claritaadelia/Incubator-Platelet-Agitator/Hasil Hardware.jpg

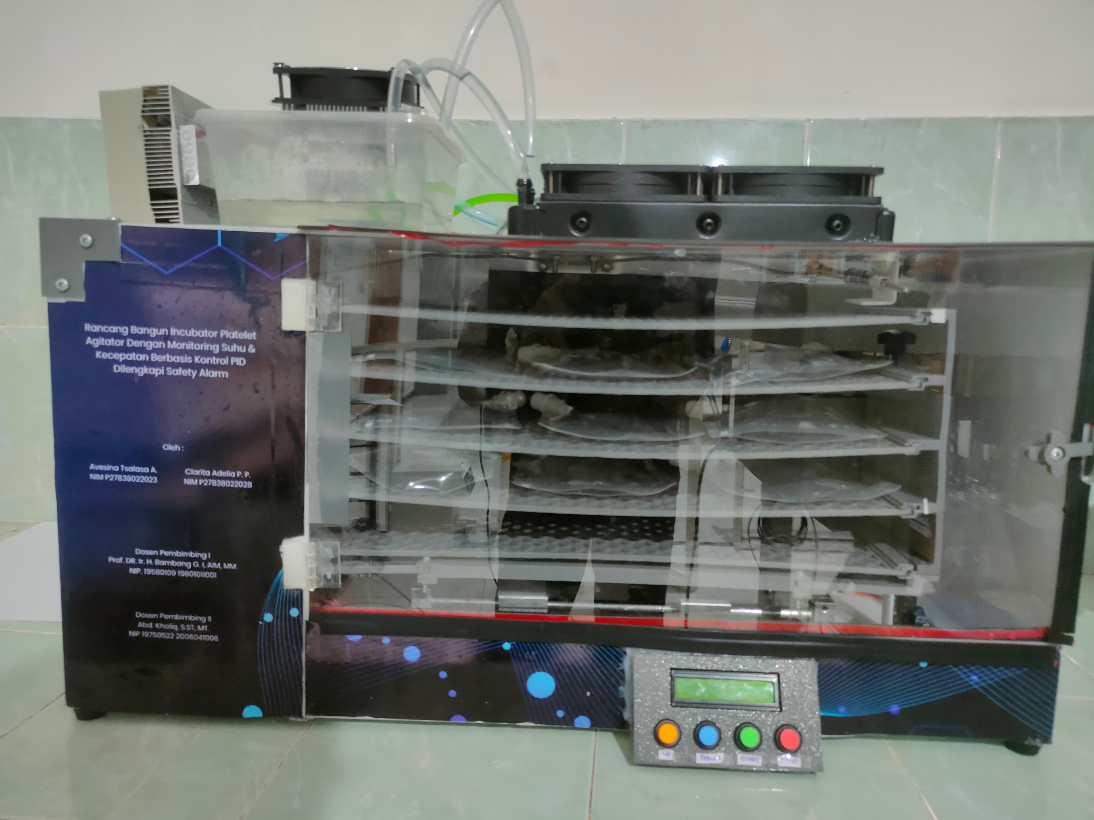
Hasil Hardware.jpg
