claritaadelia/Incubator-Platelet-Agitator/Blok diagram.jpg

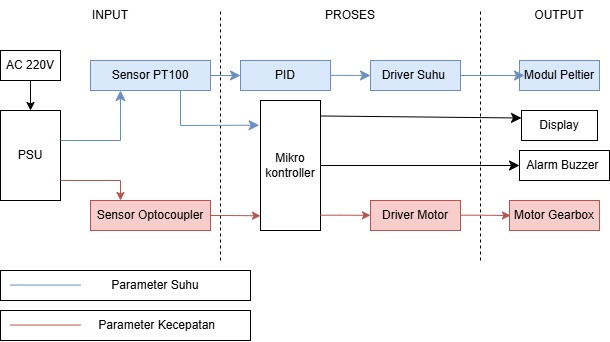
Blok diagram.jpg
