claritaadelia/Incubator-Platelet-Agitator/Diagram alir kecepatan.png

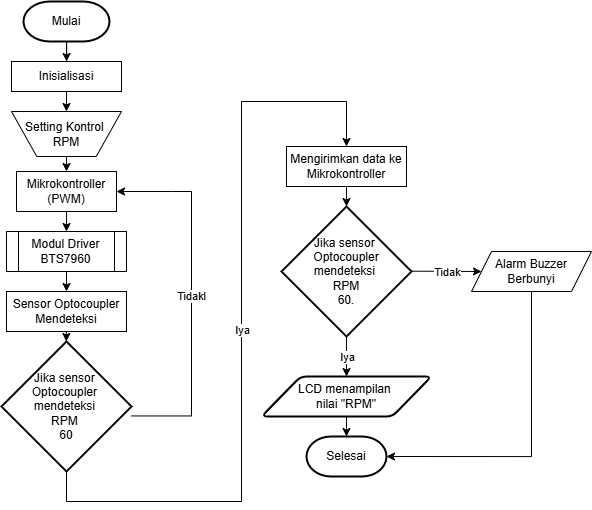
Diagram alir kecepatan.png
