claritaadelia/Incubator-Platelet-Agitator/Diagram Alir Suhu.drawio.png

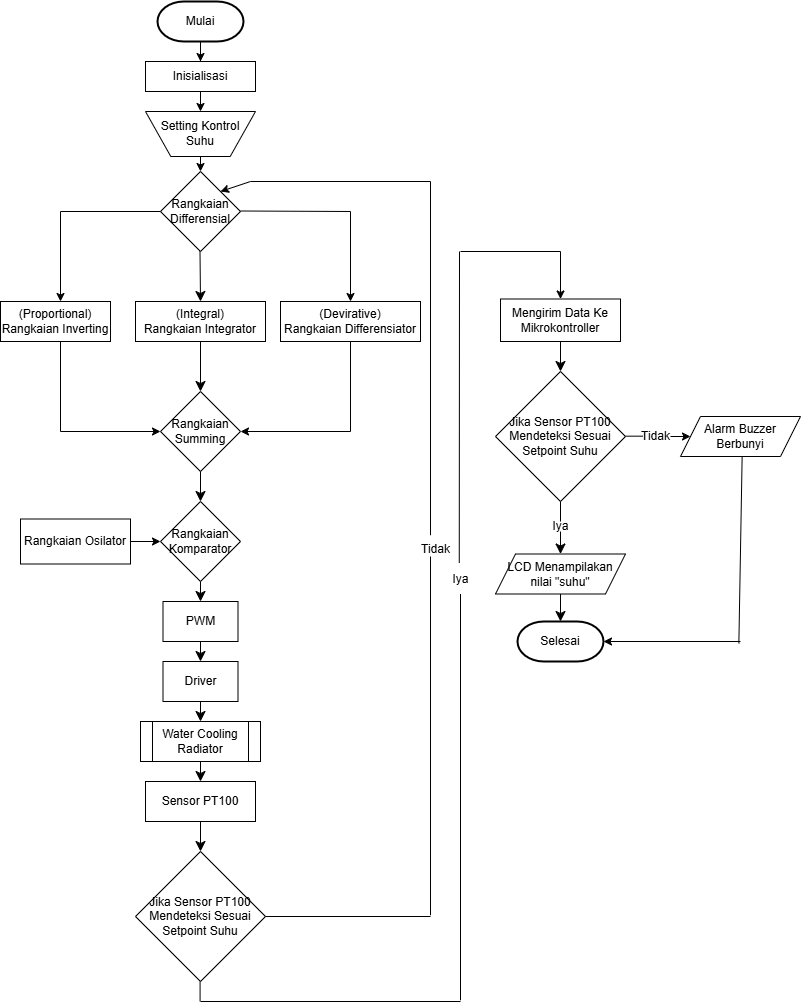
Diagram Alir Suhu.drawio.png
