claritaadelia/Incubator-Platelet-Agitator/Diagram Mekanis.png

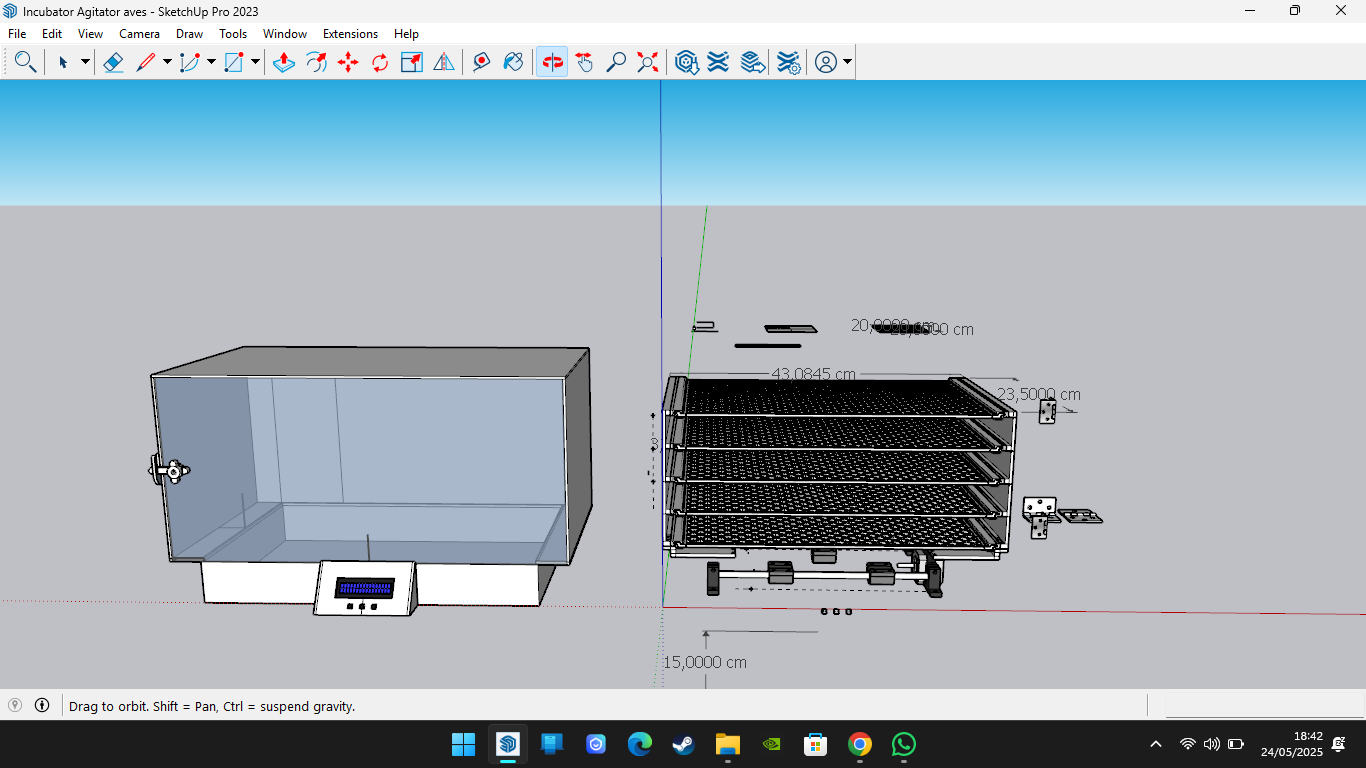
Diagram Mekanis.png
