claritaadelia/Incubator-Platelet-Agitator/MCP4725.brd

## EAGLE design MCP4725.brd (2025-05-24)

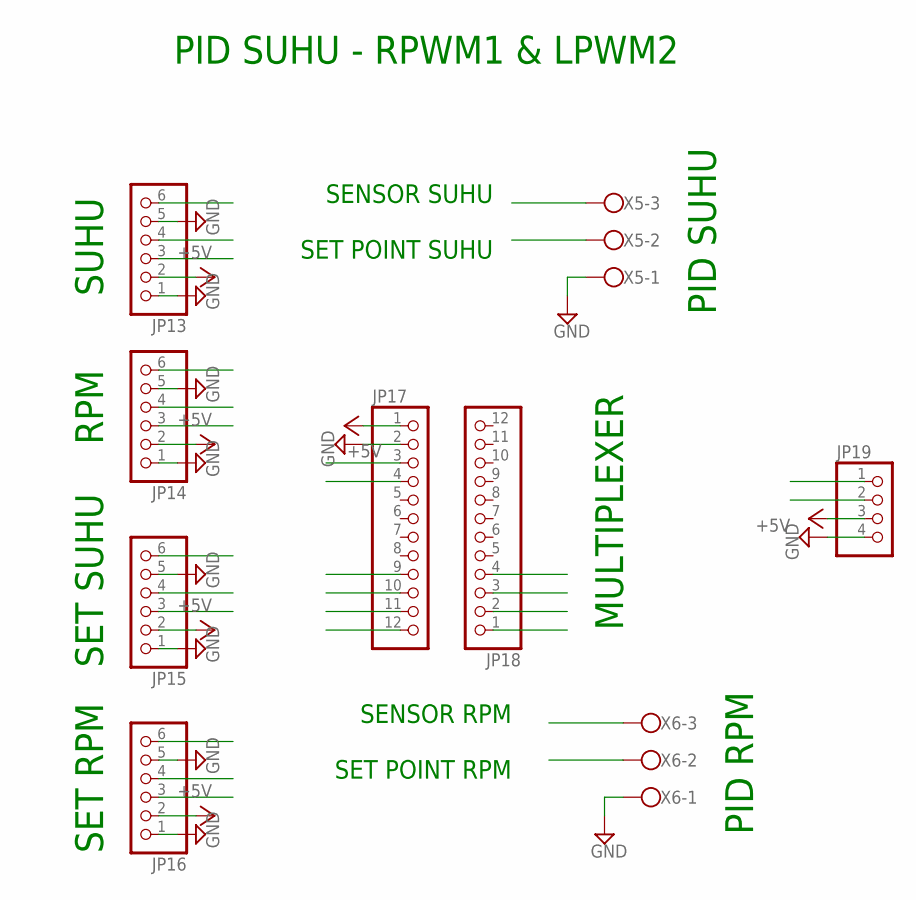
[picture p6: schematic MCP4725.sch]

Parts:
JP13, JP14, JP15, JP16: PINHD-1X6; 1X06
JP17, JP18: PINHD-1X12; 1X12
JP19: PINHD-1X4; 1X04
X5, X6: W237-103

Connections:
+5V: JP13.2, JP14.2, JP15.2, JP16.2, JP17.1, JP19.3
GND: JP13.1, JP13.5, JP14.1, JP14.5, JP15.1, JP15.5, JP16.1, JP16.5, JP17.2, JP19.4, X5.1, X6.1
unnamed: JP13.3, JP17.9
unnamed: JP13.4, JP17.10
unnamed: JP14.3, JP17.11
unnamed: JP14.4, JP17.12
unnamed: JP15.3, JP18.1
unnamed: JP15.4, JP18.2
unnamed: JP16.4, JP18.4
unnamed: JP16.3, JP18.3
unnamed: JP17.3, JP19.2
unnamed: JP17.4, JP19.1
unnamed: JP15.6, X5.2
unnamed: JP13.6, X5.3
unnamed: JP14.6, X6.3
unnamed: JP16.6, X6.2

Notes on the sheet:
SUHU
PID RPM
SET SUHU
RPM
SET RPM
PID SUHU
MULTIPLEXER
SENSOR SUHU
SET POINT SUHU
SENSOR RPM
SET POINT RPM
PID SUHU - RPWM1 & LPWM2

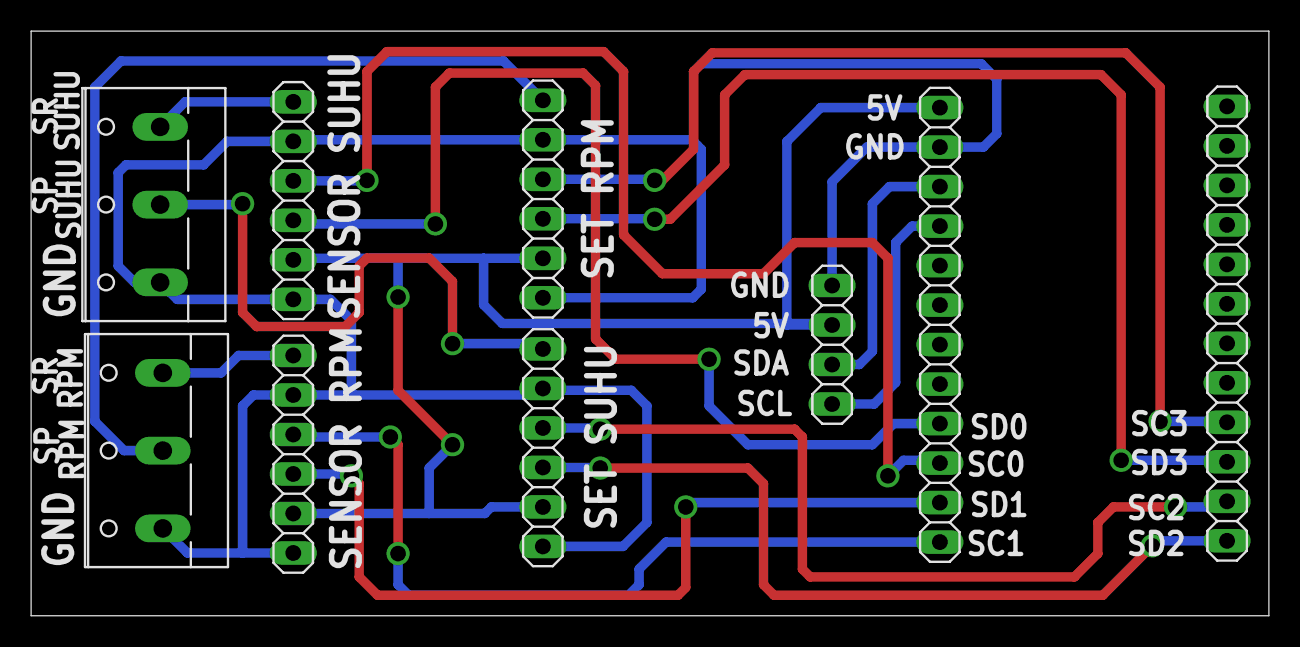
[picture p7: board MCP4725.brd from above]

Board: 2 copper layers, 79.6 x 37.6 mm, 9 parts (0 on the bottom side), 16 nets.
