claritaadelia/Incubator-Platelet-Agitator/agitator.brd

## EAGLE design agitator.brd (2025-05-24)

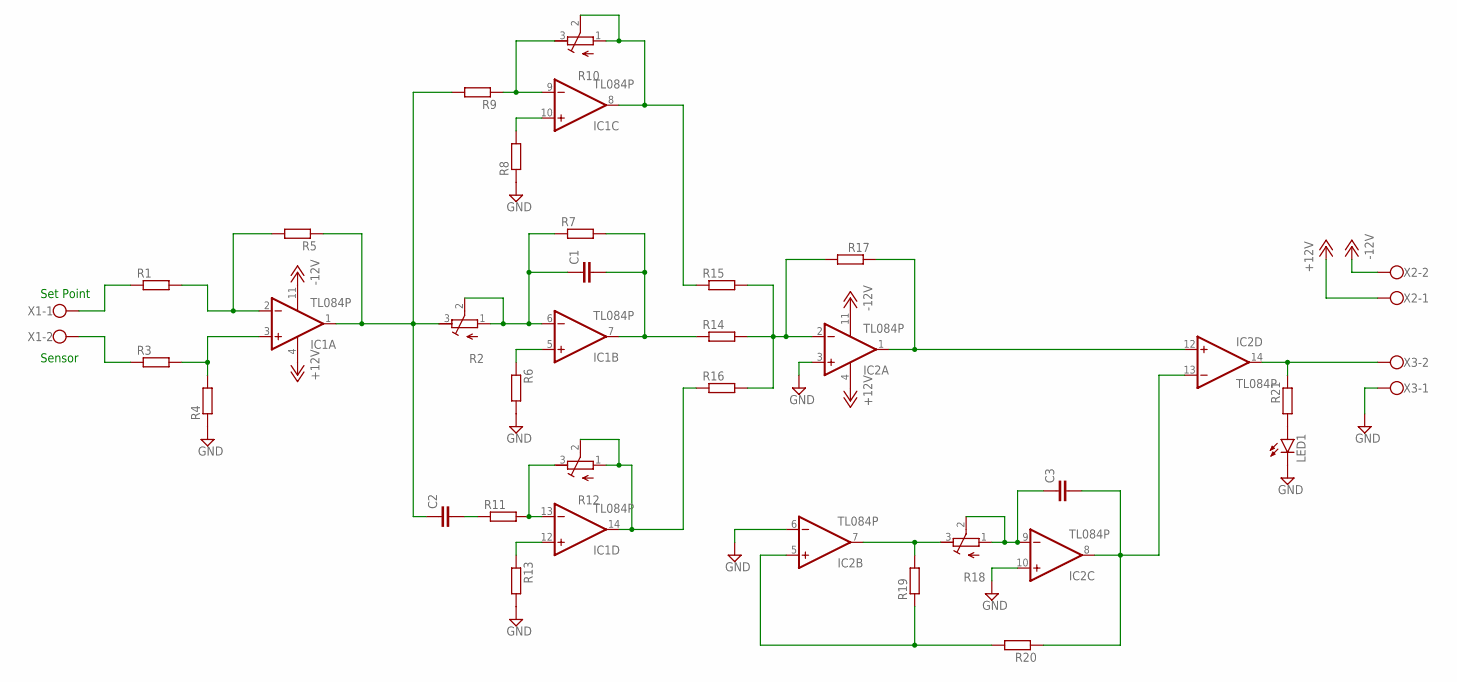
[picture p8: schematic agitator.sch]

Parts:
C1, C2, C3: C2.5/2; C2.5-2
IC1, IC2: TL084P; DIL14
LED1: LED3MM
R1, R3, R4, R5, R6, R7, R8, R9, R11, R13, R14, R15, R16, R17, R19, R20, R21: R-EU_0207/10; 0207/10
R2, R10, R12, R18: R-TRIMM64W; RTRIM64W
X1, X2, X3: W237-102

Connections:
+12V: IC1.4 (V+), IC2.4 (V+), X2.1
-12V: IC1.11 (V-), IC2.11 (V-), X2.2
GND: IC2.3 (+IN), IC2.6 (-IN), IC2.10 (+IN), LED1.K (C), R4.1, R6.2, R8.1, R13.2, X3.1
unnamed: IC1.3 (+IN), R3.2, R4.2
unnamed: IC1.2 (-IN), R1.2, R5.2
unnamed: C2.1, IC1.1 (OUT), R2.3 (E), R5.1, R9.2
unnamed: R1.1, X1.1
unnamed: R3.1, X1.2
unnamed: C1.1, IC1.6 (-IN), R2.1 (A), R2.2 (S), R7.1
unnamed: C1.2, IC1.7 (OUT), R7.2, R14.1
unnamed: IC1.5 (+IN), R6.1
unnamed: IC1.10 (+IN), R8.2
unnamed: IC1.9 (-IN), R9.1, R10.3 (E)
unnamed: C2.2, R11.1
unnamed: IC1.8 (OUT), R10.1 (A), R10.2 (S), R15.1
unnamed: IC1.13 (-IN), R11.2, R12.3 (E)
unnamed: IC1.14 (OUT), R12.1 (A), R12.2 (S), R16.1
unnamed: IC1.12 (+IN), R13.1
unnamed: IC2.2 (-IN), R14.2, R15.2, R16.2, R17.2
unnamed: IC2.1 (OUT), IC2.12 (+IN), R17.1
unnamed: IC2.7 (OUT), R18.3 (E), R19.2
unnamed: C3.1, IC2.9 (-IN), R18.1 (A), R18.2 (S)
unnamed: LED1.A, R21.2
unnamed: IC2.5 (+IN), R19.1, R20.2
unnamed: C3.2, IC2.8 (OUT), IC2.13 (-IN), R20.1
unnamed: IC2.14 (OUT), R21.1, X3.2

Notes on the sheet:
Set Point
Sensor

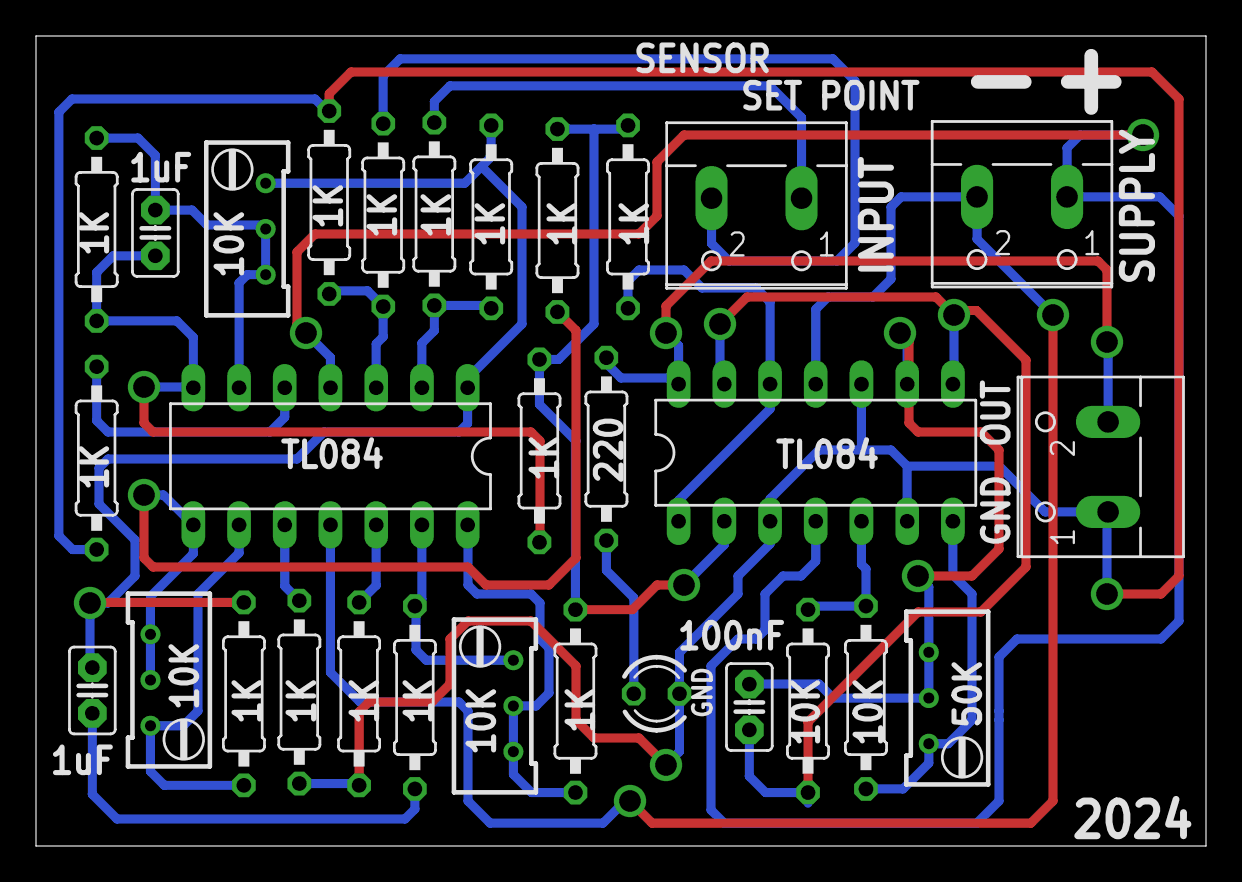
[picture p9: board agitator.brd from above]

Board: 2 copper layers, 65.0 x 45.0 mm, 30 parts (0 on the bottom side), 26 nets.
