claritaadelia/Incubator-Platelet-Agitator/SHIELD.brd

## EAGLE design SHIELD.brd (2025-05-24)

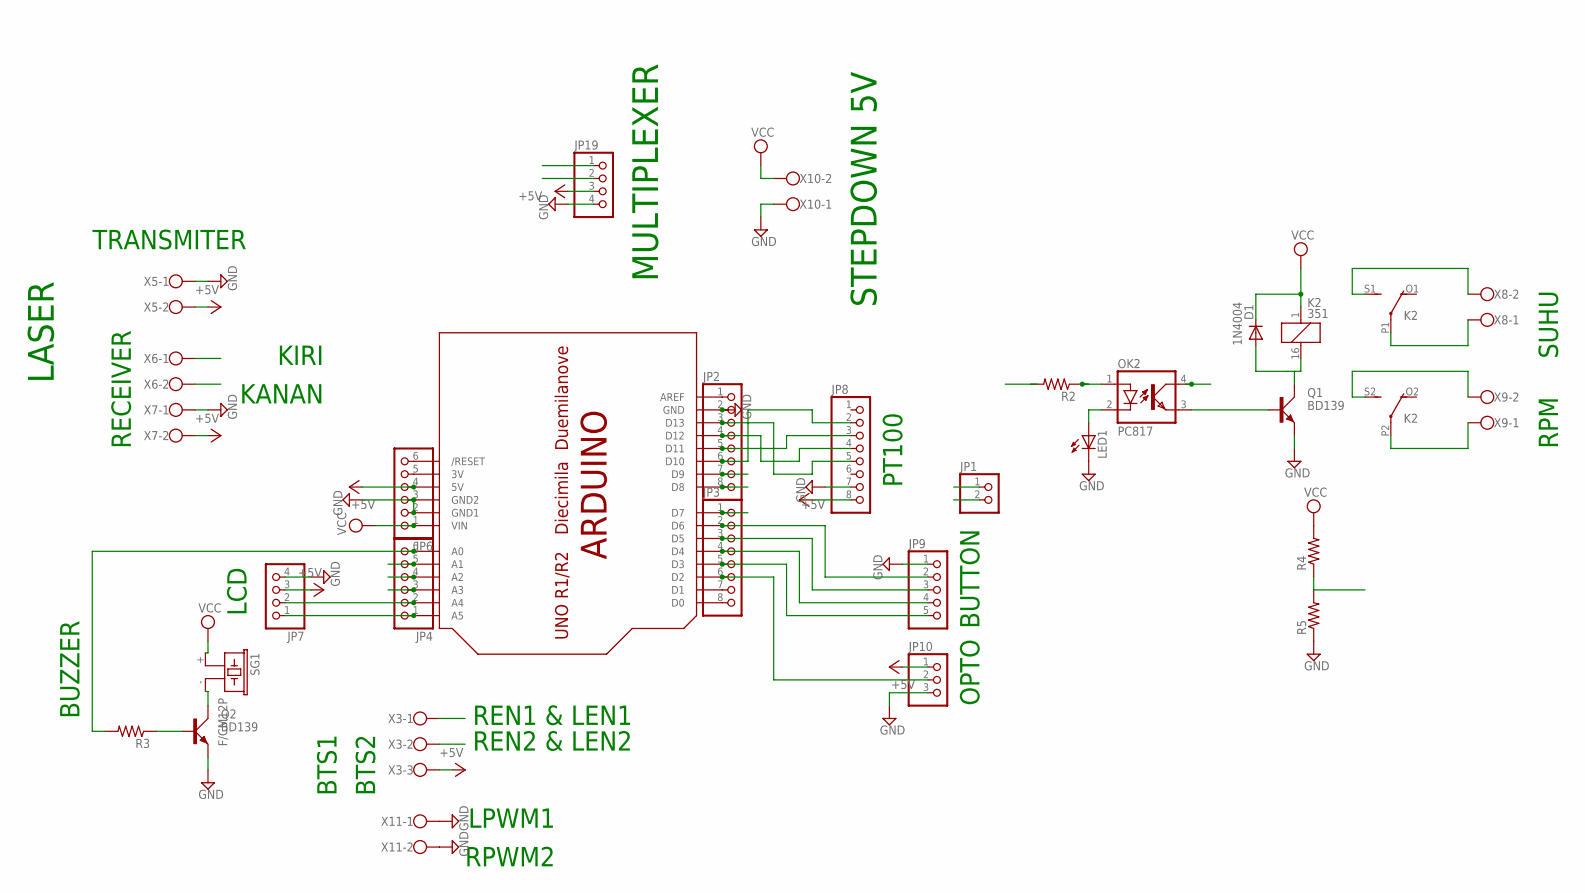
[picture p10: schematic SHIELD.sch]

Parts:
D1: 1N4004; DO41-10
JP1: PINHD-1X2; 1X02
JP2, JP3, JP8: PINHD-1X8; 1X08
JP4, JP6: PINHD-1X6; 1X06
JP7, JP19: PINHD-1X4; 1X04
JP9: PINHD-1X5; 1X05
JP10: PINHD-1X3; 1X03
K2: 351
LED1: LED5MM
OK2: PC817; DIL04
Q1, Q2: BD139; TO126AV
R2, R3, R4, R5: R-US_0207/10; 0207/10
SG1: F/CM12P
U$1: ARDUINO-NOHOLE
X3: W237-103
X5, X6, X7, X8, X9, X10, X11: W237-102

Connections:
+5V: JP6.4, JP7.3, JP8.8, JP10.1, JP19.3, U$1.5V, X3.3, X5.2, X7.2
GND: JP2.2, JP6.2, JP6.3, JP7.4, JP8.7, JP9.1, JP10.3, JP19.4, LED1.K (C), Q1.E, Q2.E, R5.1, U$1.GND, U$1.GND1, U$1.GND2, X5.1, X7.1, X10.1, X11.1, X11.2
unnamed: JP1.1, JP1.2, JP2.7, U$1.D9
unnamed: Q2.B, R3.1
unnamed: Q2.C, SG1.- (2)
unnamed: JP2.1, U$1.AREF
unnamed: JP3.7, U$1.D1
unnamed: JP3.8, U$1.D0
unnamed: JP4.2, JP7.2, JP19.2, U$1.A4
unnamed: JP4.1, JP7.1, JP19.1, U$1.A5
unnamed: JP2.6, JP8.2, U$1.D10
unnamed: JP2.5, JP8.3, U$1.D11
unnamed: JP2.4, JP8.4, U$1.D12
unnamed: JP6.5, U$1.3V
unnamed: JP6.6, U$1.RESET (/RESET)
unnamed: JP2.3, JP8.5, U$1.D13
unnamed: JP3.5, JP9.5, U$1.D3
unnamed: JP3.4, JP9.4, U$1.D4
unnamed: JP3.3, JP9.3, U$1.D5
unnamed: JP3.2, JP9.2, U$1.D6
unnamed: JP3.6, JP10.2, U$1.D2
unnamed: JP4.6, R3.2, U$1.A0
unnamed: JP4.4, U$1.A2, X3.2
unnamed: JP3.1, U$1.D7, X6.2
unnamed: JP4.5, U$1.A1, X3.1
unnamed: JP2.8, U$1.D8, X6.1
unnamed: D1.A, K2.16 (2), Q1.C
unnamed: OK2.3 (EMIT), Q1.B
unnamed: JP4.3, R2.2, U$1.A3
unnamed: LED1.A, OK2.2 (C)
unnamed: OK2.1 (A), R2.1
unnamed: K2.S1 (S), X8.2
unnamed: K2.P2, X9.1
unnamed: OK2.4 (COL), R4.1, R5.2
unnamed: K2.S2 (S), X9.2
unnamed: K2.P1, X8.1
VCC: D1.C, JP6.1, K2.1, R4.2, SG1.+ (1), U$1.VIN, X10.2

Notes on the sheet:
LCD
BTS1
BTS2
BUZZER
TRANSMITER
RECEIVER
LASER
OPTO
BUTTON
PT100
RPM
SUHU
STEPDOWN 5V
REN1 & LEN1
REN2 & LEN2
RPWM2
LPWM1
MULTIPLEXER
KANAN
KIRI

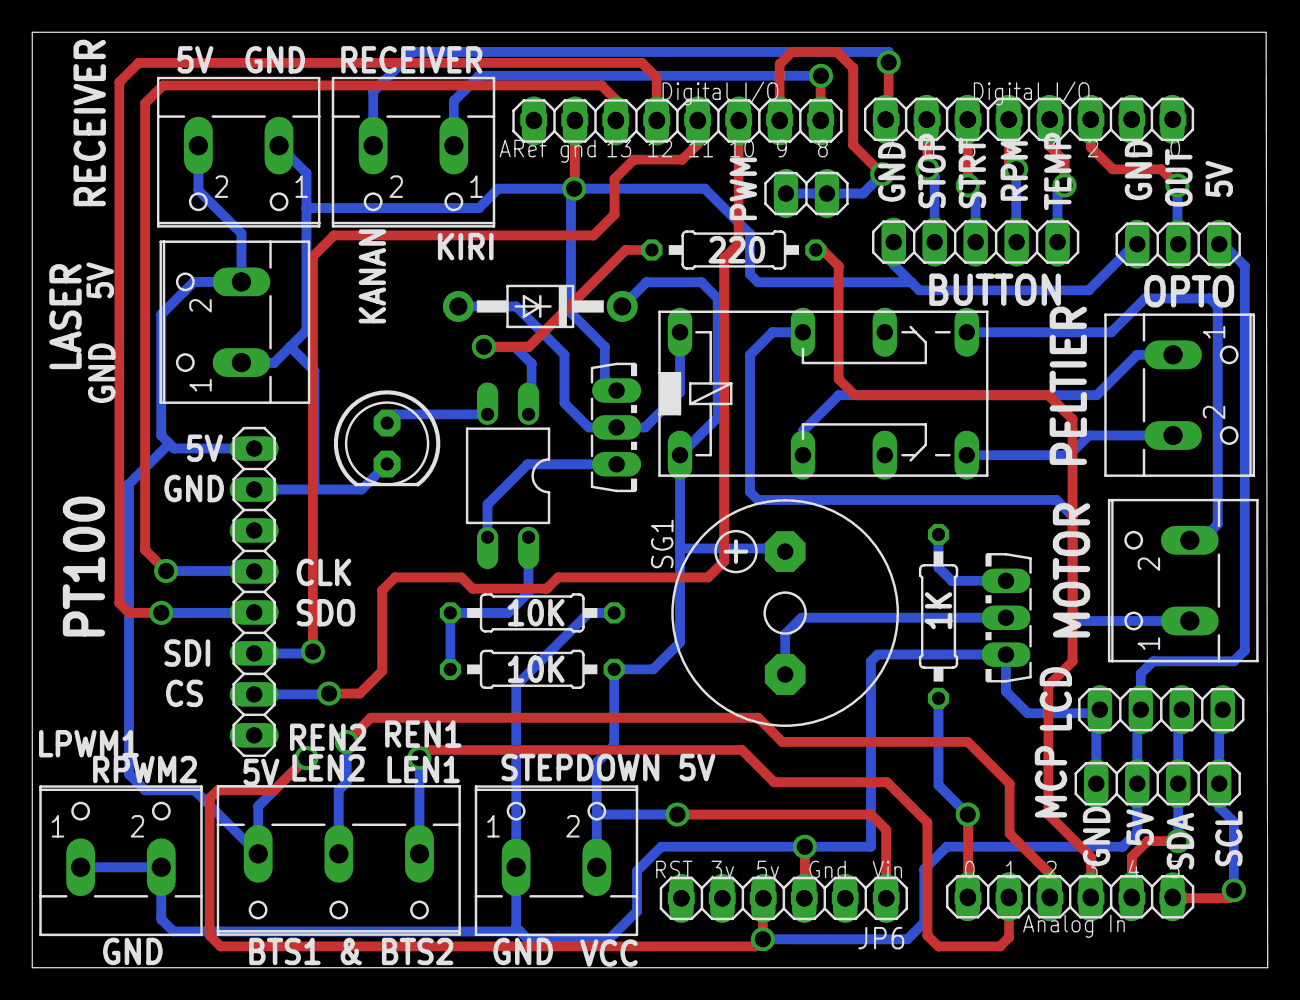
[picture p11: board SHIELD.brd from above]

Board: 2 copper layers, 76.6 x 58.0 mm, 30 parts (0 on the bottom side), 37 nets.
