claritaadelia/Incubator-Platelet-Agitator/LEVEL SHIFTER.brd

## EAGLE design LEVEL SHIFTER.brd (2025-05-24)

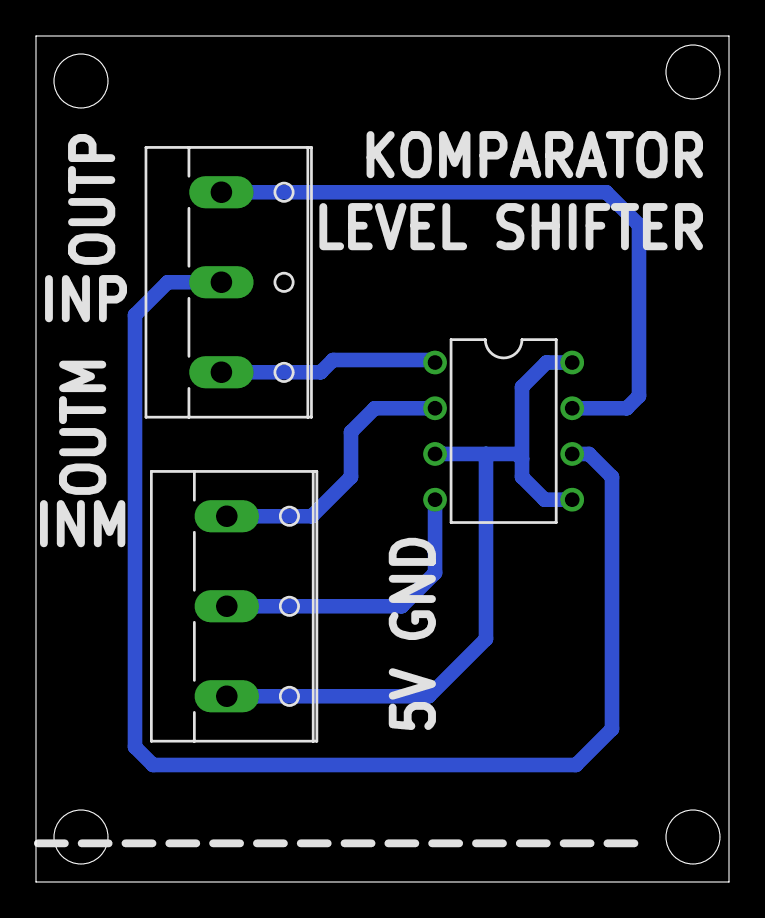
[picture p12: board LEVEL SHIFTER.brd from above]

Board: 2 copper layers, 38.5 x 47.0 mm, 3 parts (0 on the bottom side), 6 nets.

Parts:
IC1: LM358N; DIL08
X1, X2: W237-103

Connections:
+5V: IC1.3, IC1.5, IC1.8, X1.3
GND: IC1.4, X1.2
unnamed: IC1.2, X1.1
unnamed: IC1.6, X2.2
unnamed: IC1.1, X2.3
unnamed: IC1.7, X2.1
